spott/NumitronClock/review/NumitronTop-bottom.png

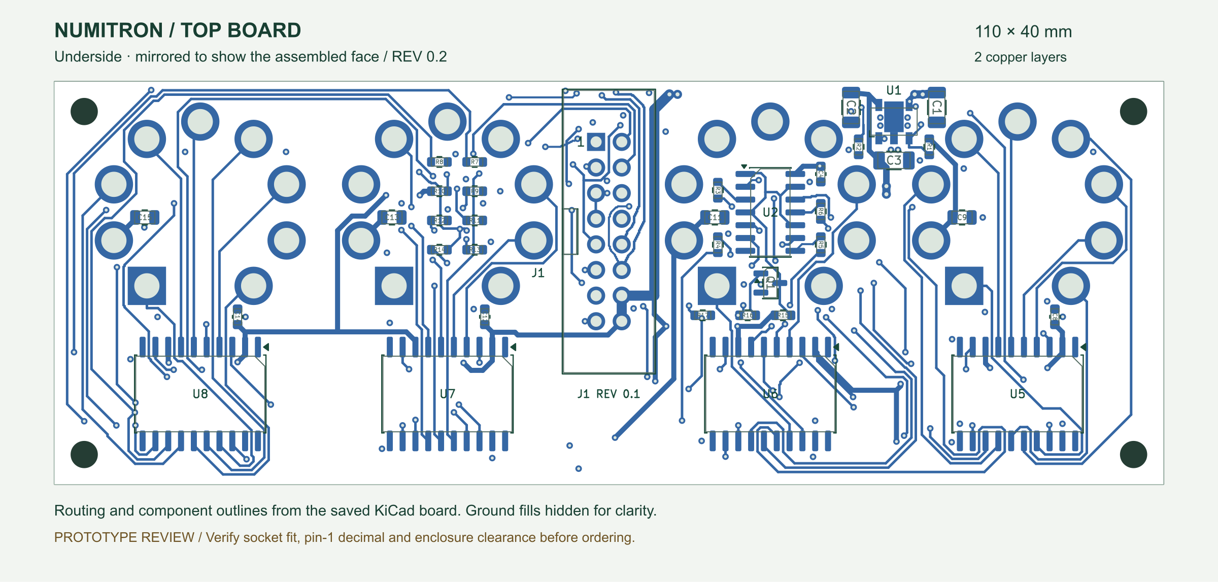
review/NumitronTop-bottom.png
