spott/NumitronClock/review/NumitronTop-top.png

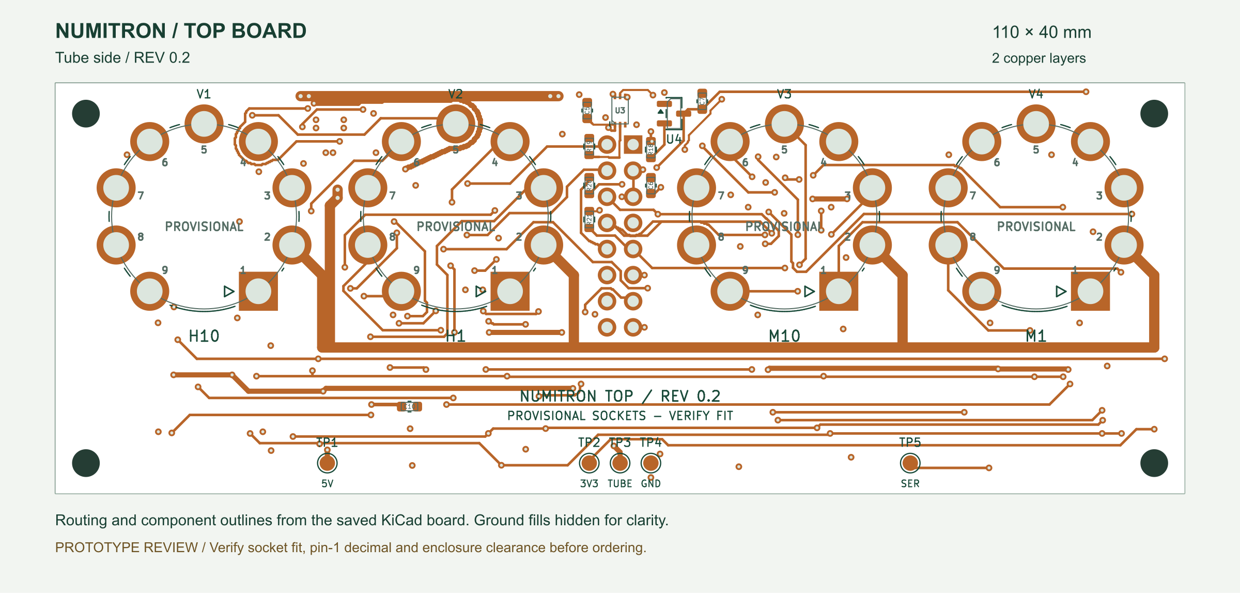
review/NumitronTop-top.png
