spott/NumitronClock/docs/bom.md

# Preliminary top-board BOM

Revision 0.2. Generated from the exported native KiCad netlist by `scripts/update_bom.py`. Quantities are for one top board. This is a review BOM, not an order or an assembly release.

| References | Qty | Value / function | Manufacturer part number | Footprint | Assembly | Datasheet |
|---|---:|---|---|---|---|---|
| C1, C2, C3 | 3 | 10u 25V X7R | KYOCERA AVX X7R family; exact order code pending | Capacitor_SMD:C_1206_3216Metric | Fit | [PDF](../datasheets/avx-x7r.pdf) |
| C4, C5, C6, C7, C8, C10, C12, C14 | 8 | 100n 50V X7R | KYOCERA AVX X7R family; exact order code pending | Capacitor_SMD:C_0603_1608Metric | Fit | [PDF](../datasheets/avx-x7r.pdf) |
| C9, C11, C13, C15 | 4 | 1u 25V X7R | KYOCERA AVX X7R family; exact order code pending | Capacitor_SMD:C_0805_2012Metric | Fit | [PDF](../datasheets/avx-x7r.pdf) |
| J1 | 1 | 61201621621 | 61201621621 | Numitron:Wurth_61201621621_2x08_P2.54mm | Fit | [PDF](../datasheets/idc-header.pdf) |
| Q1 | 1 | MMBT3904-7-F | MMBT3904-7-F | Package_TO_SOT_SMD:SOT-23 | Fit | [PDF](../datasheets/mmbt3904.pdf) |
| R1 | 1 | 46.4k 1% | RC0603FR-0746K4L | Resistor_SMD:R_0603_1608Metric | Fit | [PDF](../datasheets/RC0603FR-0746K4L.pdf) |
| R2 | 1 | 10k 1% | RC0603FR-0710KL | Resistor_SMD:R_0603_1608Metric | Fit | [PDF](../datasheets/RC0603FR-0710KL.pdf) |
| R3, R4, R5, R6 | 4 | 33R | RC0603FR-0733RL | Resistor_SMD:R_0603_1608Metric | Fit | [PDF](../datasheets/RC0603FR-0733RL.pdf) |
| R7, R8, R9 | 3 | 100k | RC0603FR-07100KL | Resistor_SMD:R_0603_1608Metric | Fit | [PDF](../datasheets/RC0603FR-07100KL.pdf) |
| R10, R16 | 2 | 2.2k | RC0603FR-072K2L | Resistor_SMD:R_0603_1608Metric | Fit | [PDF](../datasheets/RC0603FR-072K2L.pdf) |
| R11, R12, R13, R14, R17 | 5 | 4.7k | RC0603FR-074K7L | Resistor_SMD:R_0603_1608Metric | Fit | [PDF](../datasheets/RC0603FR-074K7L.pdf) |
| R15, R18 | 2 | 1k | RC0603FR-071KL | Resistor_SMD:R_0603_1608Metric | Fit | [PDF](../datasheets/RC0603FR-071KL.pdf) |
| R19 | 1 | 10k | RC0603FR-0710KL | Resistor_SMD:R_0603_1608Metric | Fit | [PDF](../datasheets/RC0603FR-0710KL.pdf) |
| R20, R21 | 2 | 4.7k | RC0603FR-074K7L | Resistor_SMD:R_0603_1608Metric | DNP | [PDF](../datasheets/RC0603FR-074K7L.pdf) |
| U1 | 1 | AP7361C-Y5-13 | AP7361C-Y5-13 | Numitron:Diodes_SOT89-5_AP7361C | Fit | [PDF](../datasheets/AP7361C.pdf) |
| U2 | 1 | SN74AHCT125DR | SN74AHCT125DR | Package_SO:SOIC-14_3.9x8.7mm_P1.27mm | Fit | [PDF](../datasheets/sn74ahct125.pdf) |
| U3 | 1 | BH1750FVI-TR | BH1750FVI-TR | Numitron:ROHM_WSOF6I_BH1750_NoCenterPad | Fit | [PDF](../datasheets/bh1750fvi.pdf) |
| U4 | 1 | TLV809EA29DBZR | TLV809EA29DBZR | Package_TO_SOT_SMD:SOT-23 | Fit | [PDF](../datasheets/tlv809e.pdf) |
| U5, U6, U7, U8 | 4 | TPIC6B595DWR | TPIC6B595DWR | Package_SO:SOIC-20W_7.5x12.8mm_P1.27mm | Fit | [PDF](../datasheets/tpic6b595.pdf) |
| V1, V2, V3, V4 | 4 | DR2000 / GZC9-A | DR2000 | Numitron:GZC9-A_B9A_Provisional | Tubes in hand; sockets separate below | [PDF](../datasheets/dr2000.pdf) |

## Mechanical and cable items

| Item | Quantity | Selection / status |
|---|---:|---|
| Tube sockets | 4 | Ordered GZC9-A, [Amazon B0BGBJ7L41](https://www.amazon.com/dp/B0BGBJ7L41). [Drawing](../datasheets/GZC9-A_socket-dimensions.jpg) archived; [provisional footprint assumptions](socket.md) authorized 2026-09-25. Assigned to V1-V4 for layout; check physical fit before ordering. |
| Cable female connectors | 2 | Wurth 61201623021, [datasheet](../datasheets/idc-socket.pdf). One at each cable end. |
| Strain-relief caps | 2 | Included in the selected Wurth socket's with-strain-relief specification; confirm supplied pieces and assembled clearance. |
| Ribbon cable | ~150 mm initially | 3M 3365/16, 28 AWG, 1.27 mm pitch, [datasheet](../datasheets/3m-3365-ribbon.pdf). Final length follows the debugging/enclosure clearance check. |
| Board spacers / screws | TBD | Four M2.5 positions with 2.7 mm nonplated holes at (3,3), (107,3), (3,37), (107,37) mm. Target 25-30 mm board separation; confirm actual screw/spacer and cable clearance. |

TP1-TP5 are bare PCB test pads; they require no purchased components. The bottom-board mate of J1 is outside this top-board BOM.

## Assembly notes

- R20/R21 are omitted when the bottom board supplies the I2C pull-ups. All selected resistors are Yageo RC0603, 1%, 0.1 W; individual part specifications are archived.
- Capacitor footprint sizes, voltage ratings and dielectric are specified, but exact order codes remain pending. Select from the archived KYOCERA AVX X7R family, and verify effective capacitance at bias before freezing the BOM. C2+C3 must retain at least 2.2 uF total.
- V1-V4 use Numitron:GZC9-A_B9A_Provisional: assumed 0.5 mm terminal thickness, 18 mm pad circle, 2.5 mm plated holes and 3.8 mm copper pads. The owner authorized using these estimates for layout; verify fit before ordering.
- U3 uses the custom six-land WSOF6I footprint with no soldered centre pad and a front copper keepout; see layout notes for the older package drawing correspondence. U1 and J1 use manufacturer-specific local footprints.
- U1's C507885 identifier comes from the Obsidian plan. Stock, price, assembly-house availability and substitutions have not been qualified.
- Use normal-pinout TLV809EA29DBZR, not an R/V pinout variant. Use AHCT logic, not HC. The four TPIC parts use the wide SOIC-20 package.
