spott/NumitronClock/hardware/top-board/NumitronTop.kicad_pcb

## KiCad design hardware/top-board/NumitronTop.kicad_pcb (2026-09-26)

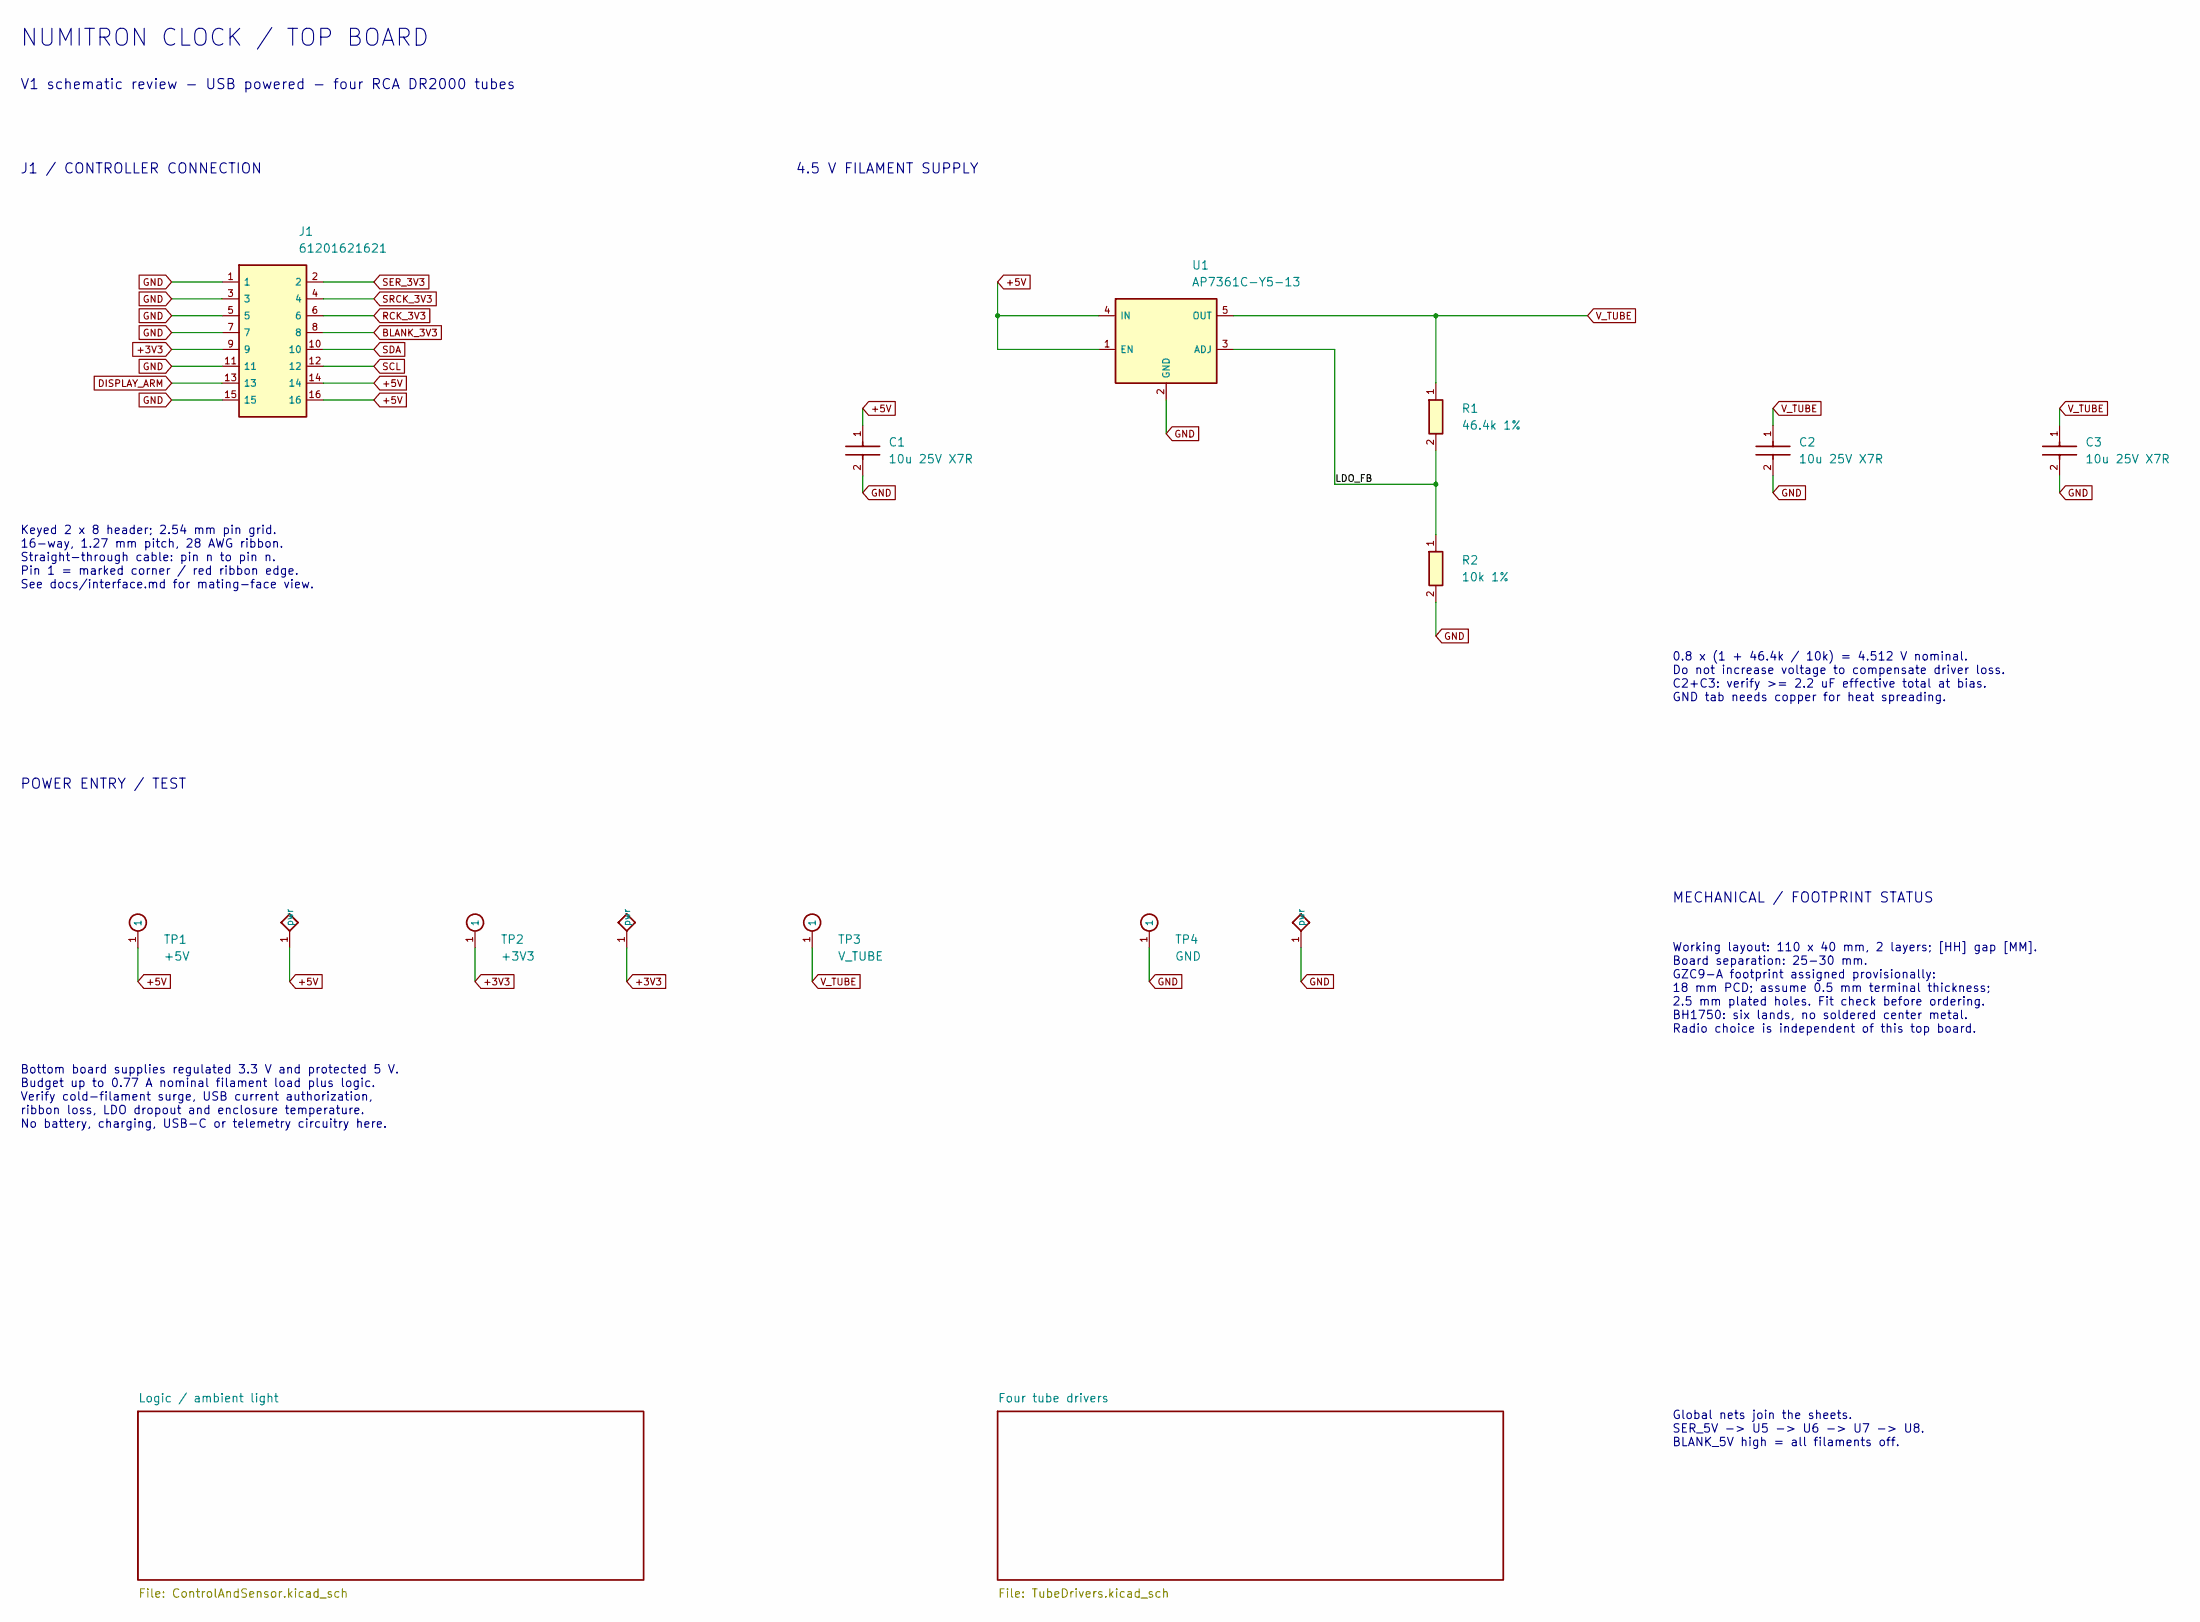
[picture p4: schematic NumitronTop.kicad_sch, Top board: power and interface]

Parts:
C1, C2, C3: 10u 25V X7R; C_1206_3216Metric
J1: 61201621621; Wurth_61201621621_2x08_P2.54mm; MPN 61201621621
R1: 46.4k 1%; R_0603_1608Metric; MPN RC0603FR-0746K4L
R2: 10k 1%; R_0603_1608Metric; MPN RC0603FR-0710KL
TP1: +5V; TestPoint_Pad_D1.5mm
TP2: +3V3; TestPoint_Pad_D1.5mm
TP3: V_TUBE; TestPoint_Pad_D1.5mm
TP4: GND; TestPoint_Pad_D1.5mm
U1: AP7361C-Y5-13; Diodes_SOT89-5_AP7361C; MPN AP7361C-Y5-13; LCSC C507885

Connections:
+3V3: J1.9, TP2.1; also elsewhere on the board
+5V: C1.1, J1.14, J1.16, TP1.1, U1.1 (EN), U1.4 (IN); also elsewhere on the board
/LDO_FB: R1.2, R2.1, U1.3 (ADJ)
BLANK_3V3: J1.8; also elsewhere on the board
DISPLAY_ARM: J1.13; also elsewhere on the board
GND: C1.2, C2.2, C3.2, J1.1, J1.3, J1.5, J1.7, J1.11, J1.15, R2.2, TP4.1, U1.2 (GND); also elsewhere on the board
RCK_3V3: J1.6; also elsewhere on the board
SCL: J1.12; also elsewhere on the board
SDA: J1.10; also elsewhere on the board
SER_3V3: J1.2; also elsewhere on the board
SRCK_3V3: J1.4; also elsewhere on the board
V_TUBE: C2.1, C3.1, R1.1, TP3.1, U1.5 (OUT); also elsewhere on the board

Notes on the sheet:
NUMITRON CLOCK / TOP BOARD
V1 schematic review - USB powered - four RCA DR2000 tubes
J1 / CONTROLLER CONNECTION
Keyed 2 x 8 header; 2.54 mm pin grid. 16-way, 1.27 mm pitch, 28 AWG ribbon. Straight-through cable: pin n to pin n. Pin 1 = marked corner / red ribbon edge. See docs/interface.md for mating-face view.
4.5 V FILAMENT SUPPLY
0.8 x (1 + 46.4k / 10k) = 4.512 V nominal. Do not increase voltage to compensate driver loss. C2+C3: verify >= 2.2 uF effective total at bias. GND tab needs copper for heat spreading.
POWER ENTRY / TEST
Bottom board supplies regulated 3.3 V and protected 5 V. Budget up to 0.77 A nominal filament load plus logic. Verify cold-filament surge, USB current authorization, ribbon loss, LDO dropout and enclosure temperature. No battery, charging, USB-C or telemetry circuitry here.
MECHANICAL / FOOTPRINT STATUS
Working layout: 110 x 40 mm, 2 layers; [HH] gap [MM]. Board separation: 25-30 mm. GZC9-A footprint assigned provisionally: 18 mm PCD; assume 0.5 mm terminal thickness; 2.5 mm plated holes. Fit check before ordering. BH1750: six lands, no soldered center metal. Radio choice is independent of this to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
Global nets join the sheets. SER_5V -> U5 -> U6 -> U7 -> U8. BLANK_5V high = all filaments off.

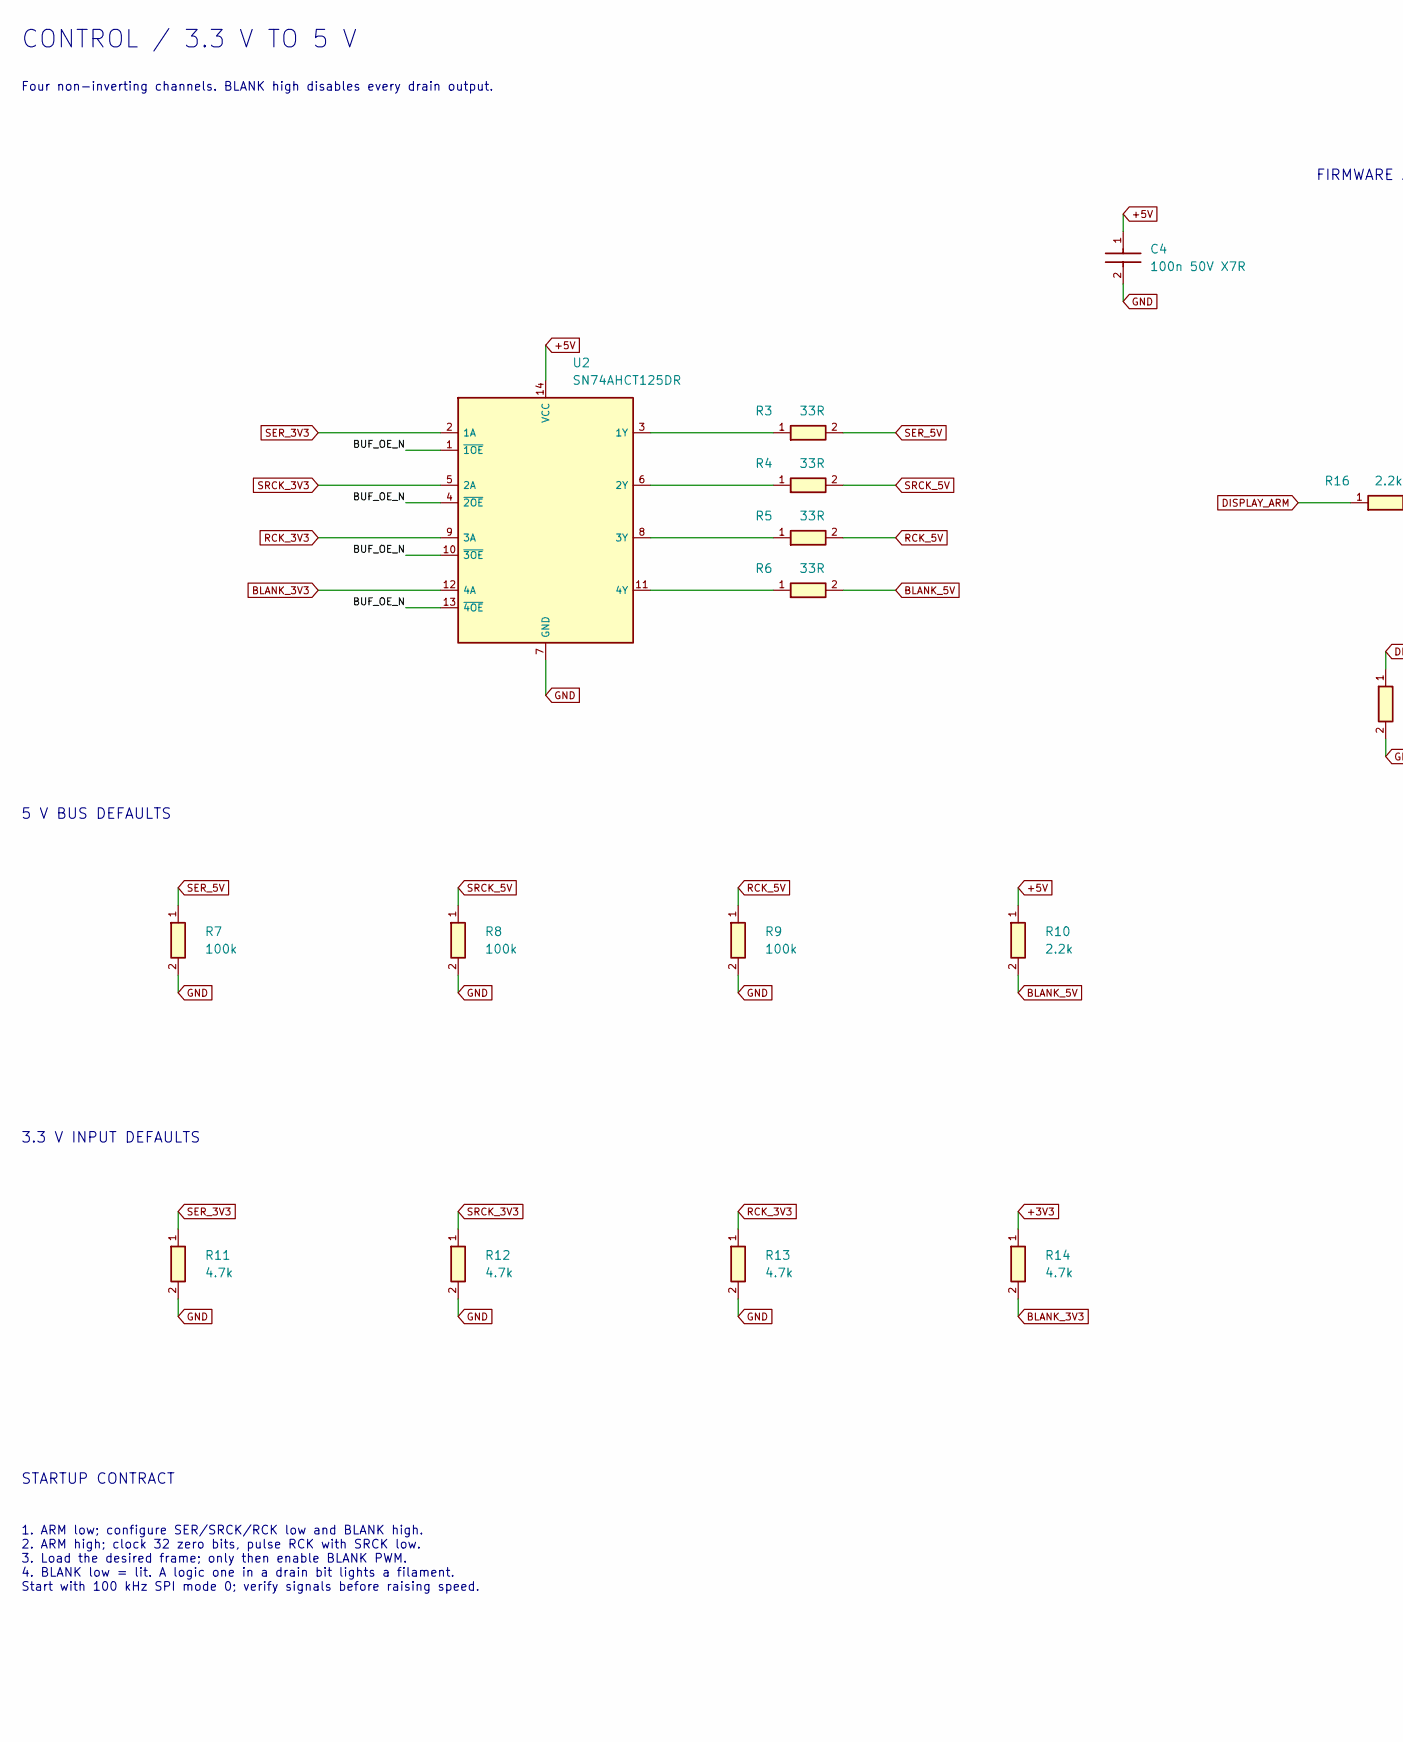
[picture p5: schematic ControlAndSensor.kicad_sch, Top board: control and light sensor, part in row 1, column 1]

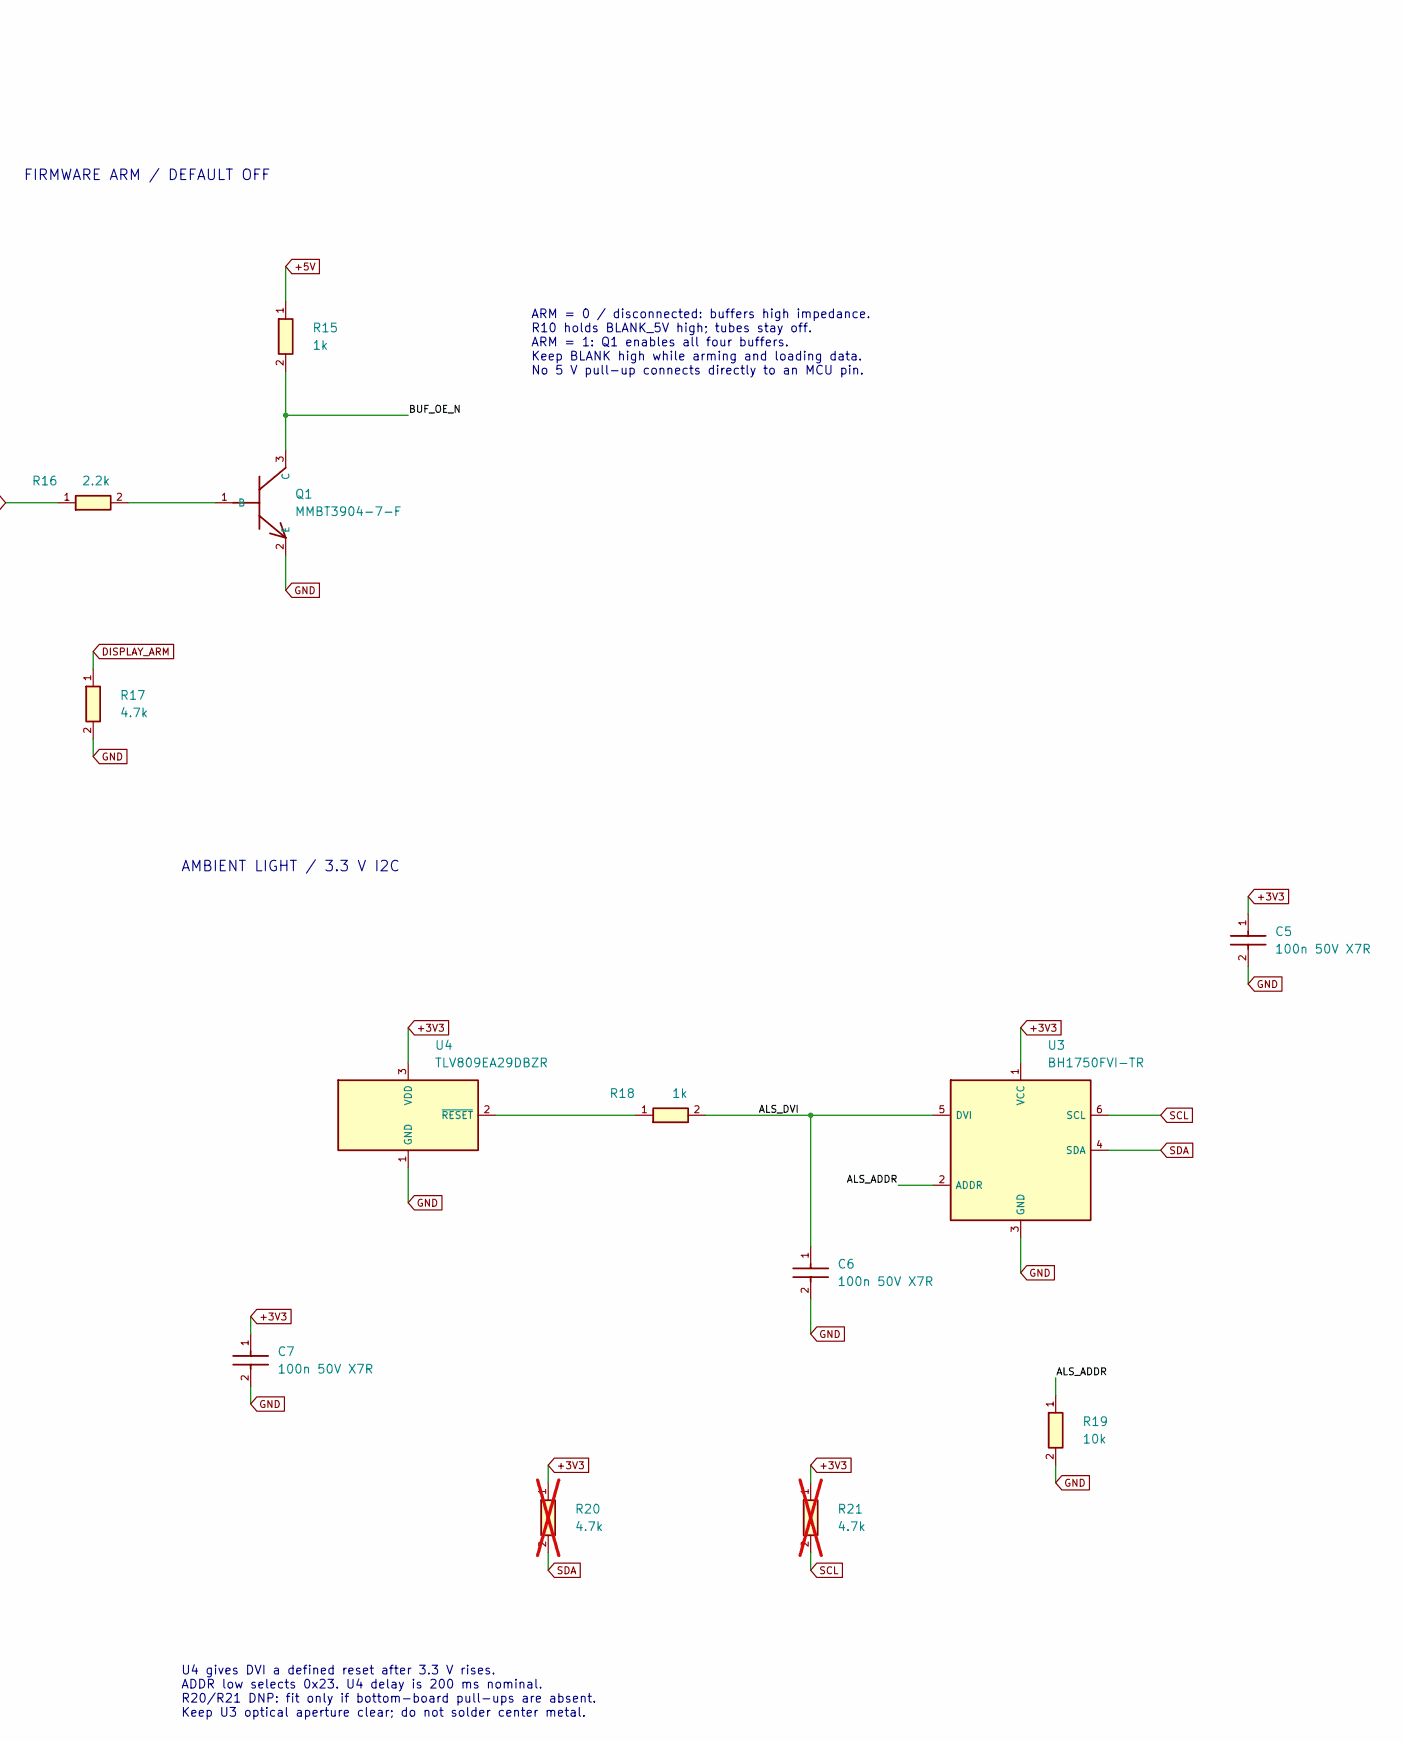
[picture p6: schematic ControlAndSensor.kicad_sch, Top board: control and light sensor, part in row 1, column 2]

Parts:
C4, C5, C6, C7: 100n 50V X7R; C_0603_1608Metric
Q1: MMBT3904-7-F; SOT-23; MPN MMBT3904-7-F
R3, R4, R5, R6: 33R; R_0603_1608Metric; MPN RC0603FR-0733RL
R7, R8, R9: 100k; R_0603_1608Metric; MPN RC0603FR-07100KL
R10, R16: 2.2k; R_0603_1608Metric; MPN RC0603FR-072K2L
R11, R12, R13, R14, R17: 4.7k; R_0603_1608Metric; MPN RC0603FR-074K7L
R15, R18: 1k; R_0603_1608Metric; MPN RC0603FR-071KL
R19: 10k; R_0603_1608Metric; MPN RC0603FR-0710KL
R20, R21: 4.7k; R_0603_1608Metric; MPN RC0603FR-074K7L; not fitted
U2: SN74AHCT125DR; SOIC-14_3.9x8.7mm_P1.27mm; MPN SN74AHCT125DR
U3: BH1750FVI-TR; ROHM_WSOF6I_BH1750_NoCenterPad; MPN BH1750FVI-TR
U4: TLV809EA29DBZR; SOT-23; MPN TLV809EA29DBZR

Connections:
+3V3: C5.1, C7.1, R14.1, R20.1, R21.1, U3.1 (VCC), U4.3 (VDD); also elsewhere on the board
+5V: C4.1, R10.1, R15.1, U2.14 (VCC); also elsewhere on the board
/Logic / ambient light/ALS_ADDR: R19.1, U3.2 (ADDR)
/Logic / ambient light/ALS_DVI: C6.1, R18.2, U3.5 (DVI)
/Logic / ambient light/BUF_OE_N: Q1.3 (C), R15.2, U2.1 (~1OE), U2.4 (~2OE), U2.10 (~3OE), U2.13 (~4OE)
BLANK_3V3: R14.2, U2.12 (4A); also elsewhere on the board
BLANK_5V: R6.2, R10.2; also elsewhere on the board
DISPLAY_ARM: R16.1, R17.1; also elsewhere on the board
GND: C4.2, C5.2, C6.2, C7.2, Q1.2 (E), R7.2, R8.2, R9.2, R11.2, R12.2, R13.2, R17.2, R19.2, U2.7 (GND), U3.3 (GND), U4.1 (GND); also elsewhere on the board
unnamed: Q1.1 (B), R16.2
unnamed: R3.1, U2.3 (1Y)
unnamed: R4.1, U2.6 (2Y)
unnamed: R5.1, U2.8 (3Y)
unnamed: R6.1, U2.11 (4Y)
unnamed: R18.1, U4.2 (~RESET)
RCK_3V3: R13.1, U2.9 (3A); also elsewhere on the board
RCK_5V: R5.2, R9.1; also elsewhere on the board
SCL: R21.2, U3.6 (SCL); also elsewhere on the board
SDA: R20.2, U3.4 (SDA); also elsewhere on the board
SER_3V3: R11.1, U2.2 (1A); also elsewhere on the board
SER_5V: R3.2, R7.1; also elsewhere on the board
SRCK_3V3: R12.1, U2.5 (2A); also elsewhere on the board
SRCK_5V: R4.2, R8.1; also elsewhere on the board

Notes on the sheet:
CONTROL / 3.3 V TO 5 V
Four non-inverting channels. BLANK high disables every drain output.
FIRMWARE ARM / DEFAULT OFF
ARM = 0 / disconnected: buffers high impedance. R10 holds BLANK_5V high; tubes stay off. ARM = 1: Q1 enables all four buffers. Keep BLANK high while arming and loading data. No 5 V pull-up connects directly to an MCU pin.
5 V BUS DEFAULTS
3.3 V INPUT DEFAULTS
STARTUP CONTRACT
1. ARM low; configure SER/SRCK/RCK low and BLANK high. 2. ARM high; clock 32 zero bits, pulse RCK with SRCK low. 3. Load the desired frame; only then enable BLANK PWM. 4. BLANK low = lit. A logic one in a drain bit lights a filament. Start with 100 kHz SPI mode 0; verify signals before raising spee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
AMBIENT LIGHT / 3.3 V I2C
U4 gives DVI a defined reset after 3.3 V rises. ADDR low selects 0x23. U4 delay is 200 ms nominal. R20/R21 DNP: fit only if bottom-board pull-ups are absent. Keep U3 optical aperture clear; do not solder center metal.

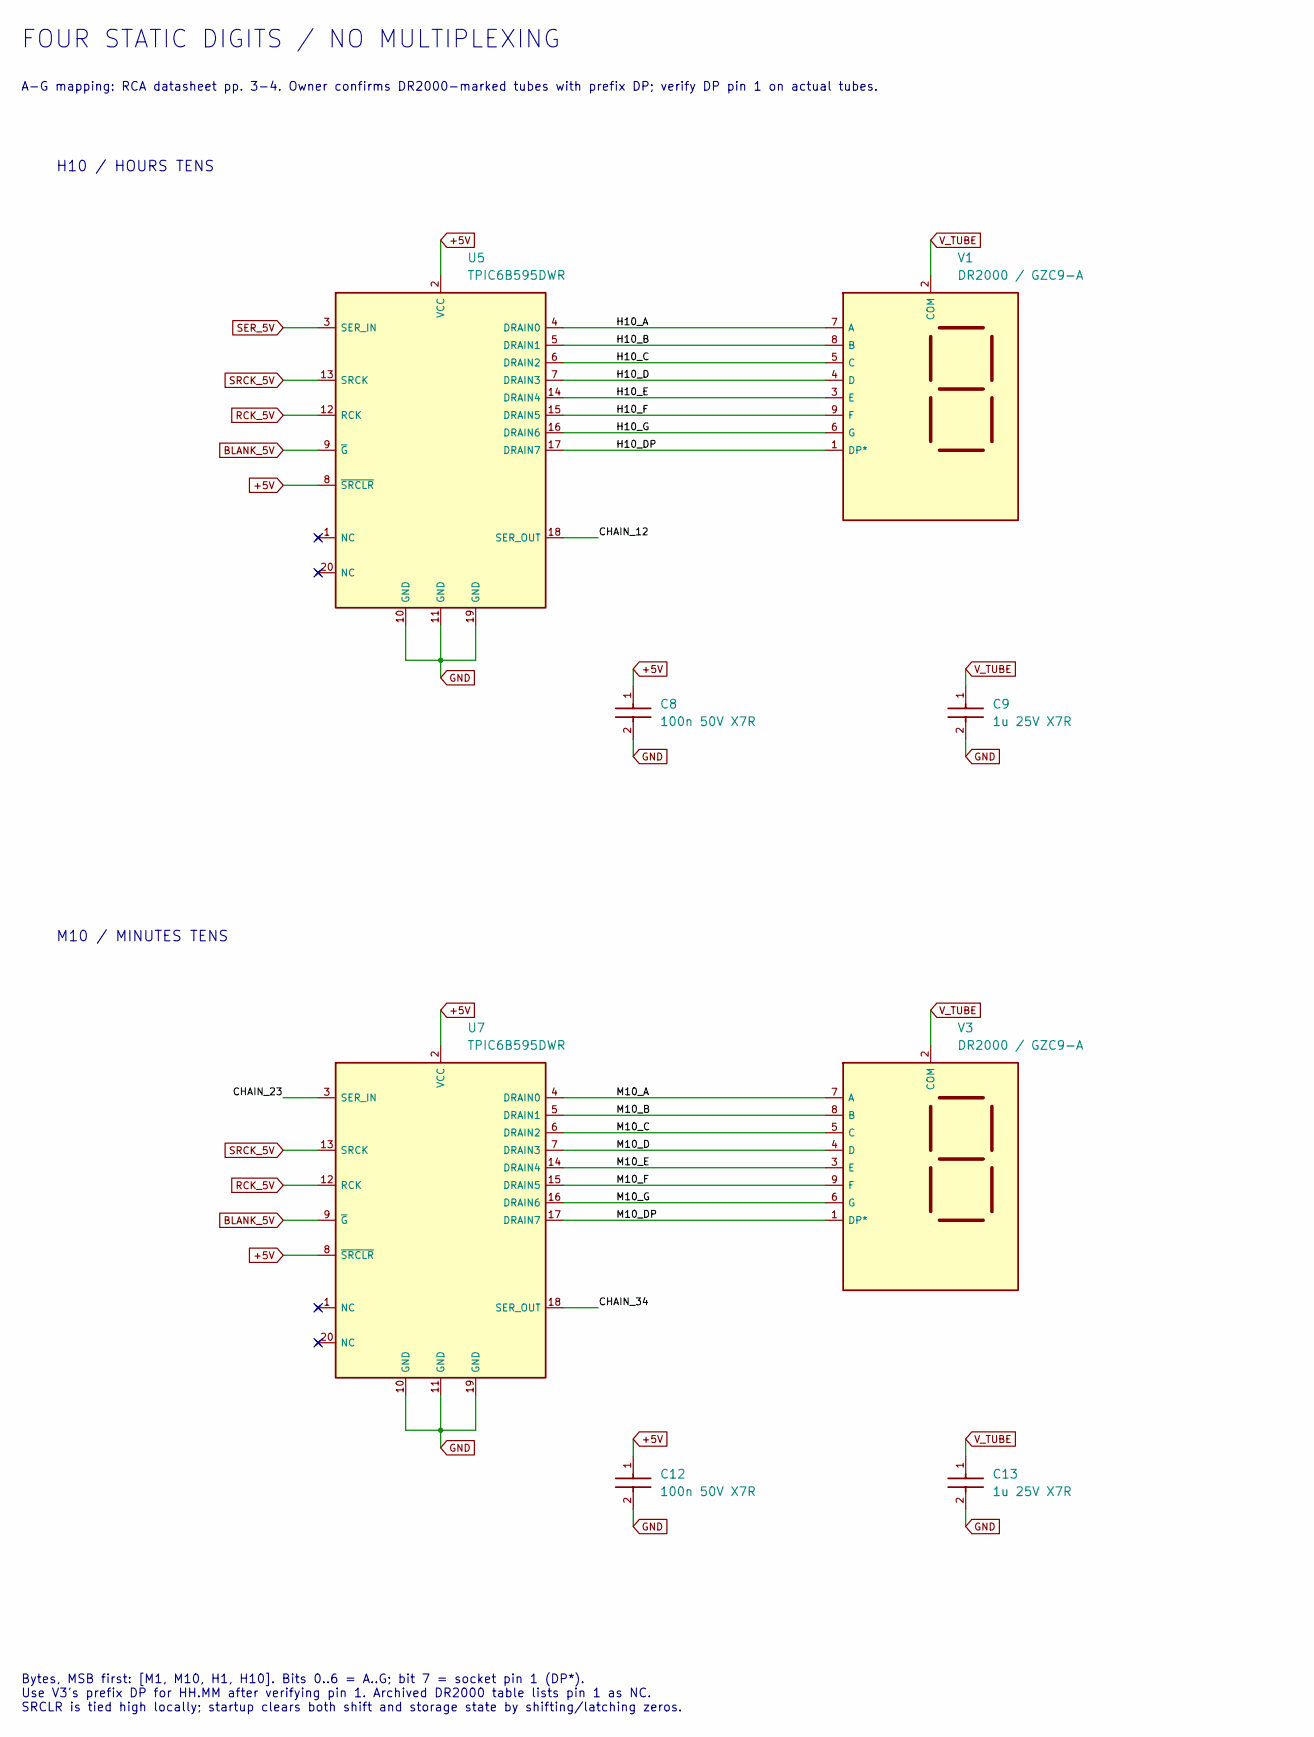
[picture p7: schematic TubeDrivers.kicad_sch, Top board: tube drivers, part in row 1, column 1]

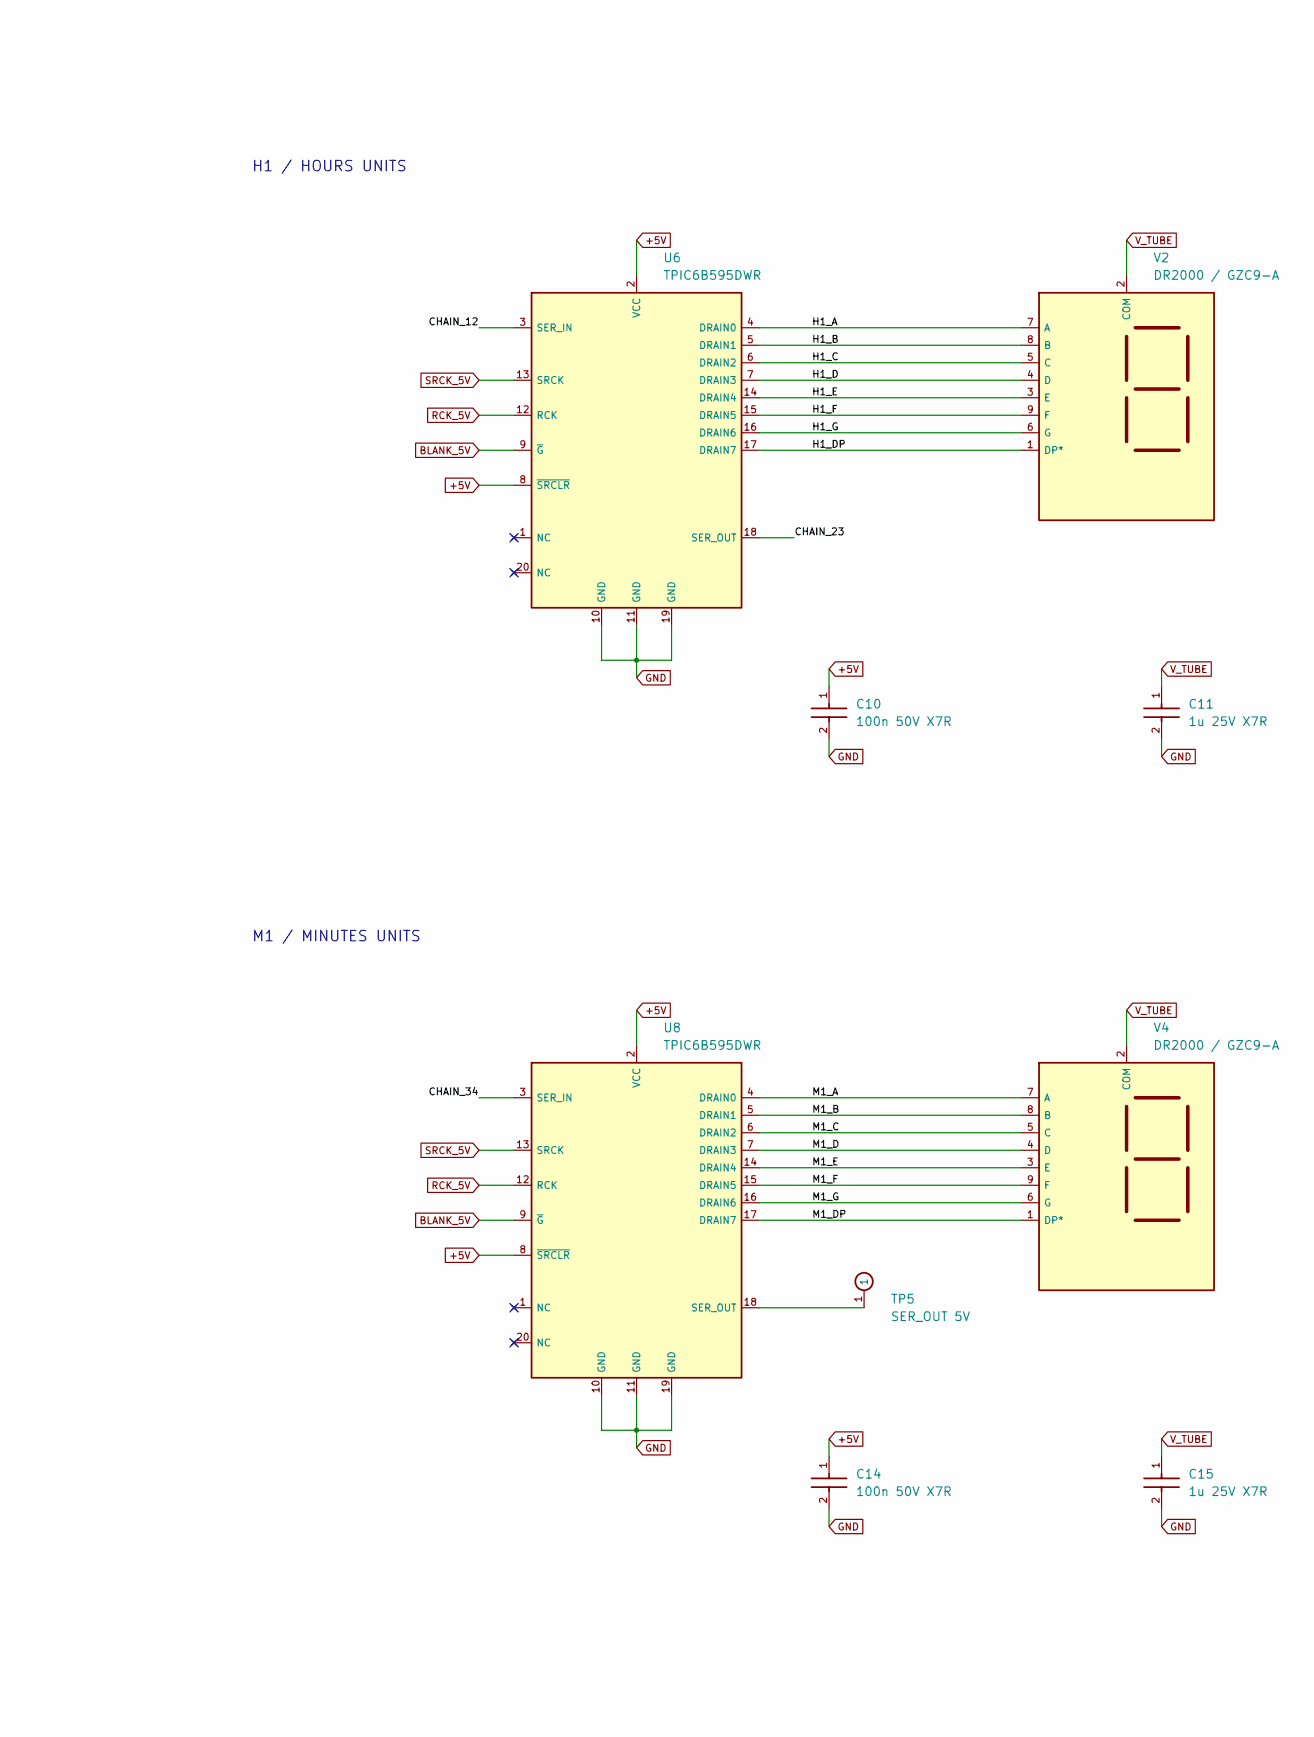
[picture p8: schematic TubeDrivers.kicad_sch, Top board: tube drivers, part in row 1, column 2]

Parts:
C8, C10, C12, C14: 100n 50V X7R; C_0603_1608Metric
C9, C11, C13, C15: 1u 25V X7R; C_0805_2012Metric
TP5: SER_OUT 5V; TestPoint_Pad_D1.5mm
U5, U6, U7, U8: TPIC6B595DWR; SOIC-20W_7.5x12.8mm_P1.27mm; MPN TPIC6B595DWR
V1, V2, V3, V4: DR2000 / GZC9-A; GZC9-A_B9A_Provisional; MPN DR2000

Connections:
+5V: C8.1, C10.1, C12.1, C14.1, U5.2 (VCC), U5.8 (~SRCLR), U6.2 (VCC), U6.8 (~SRCLR), U7.2 (VCC), U7.8 (~SRCLR), U8.2 (VCC), U8.8 (~SRCLR); also elsewhere on the board
/Four tube drivers/CHAIN_12: U5.18 (SER_OUT), U6.3 (SER_IN)
/Four tube drivers/CHAIN_23: U6.18 (SER_OUT), U7.3 (SER_IN)
/Four tube drivers/CHAIN_34: U7.18 (SER_OUT), U8.3 (SER_IN)
/Four tube drivers/H1_A: U6.4 (DRAIN0), V2.7 (A)
/Four tube drivers/H1_B: U6.5 (DRAIN1), V2.8 (B)
/Four tube drivers/H1_C: U6.6 (DRAIN2), V2.5 (C)
/Four tube drivers/H1_D: U6.7 (DRAIN3), V2.4 (D)
/Four tube drivers/H1_DP: U6.17 (DRAIN7), V2.1 (DP*)
/Four tube drivers/H1_E: U6.14 (DRAIN4), V2.3 (E)
/Four tube drivers/H1_F: U6.15 (DRAIN5), V2.9 (F)
/Four tube drivers/H1_G: U6.16 (DRAIN6), V2.6 (G)
/Four tube drivers/H10_A: U5.4 (DRAIN0), V1.7 (A)
/Four tube drivers/H10_B: U5.5 (DRAIN1), V1.8 (B)
/Four tube drivers/H10_C: U5.6 (DRAIN2), V1.5 (C)
/Four tube drivers/H10_D: U5.7 (DRAIN3), V1.4 (D)
/Four tube drivers/H10_DP: U5.17 (DRAIN7), V1.1 (DP*)
/Four tube drivers/H10_E: U5.14 (DRAIN4), V1.3 (E)
/Four tube drivers/H10_F: U5.15 (DRAIN5), V1.9 (F)
/Four tube drivers/H10_G: U5.16 (DRAIN6), V1.6 (G)
/Four tube drivers/M1_A: U8.4 (DRAIN0), V4.7 (A)
/Four tube drivers/M1_B: U8.5 (DRAIN1), V4.8 (B)
/Four tube drivers/M1_C: U8.6 (DRAIN2), V4.5 (C)
/Four tube drivers/M1_D: U8.7 (DRAIN3), V4.4 (D)
/Four tube drivers/M1_DP: U8.17 (DRAIN7), V4.1 (DP*)
/Four tube drivers/M1_E: U8.14 (DRAIN4), V4.3 (E)
/Four tube drivers/M1_F: U8.15 (DRAIN5), V4.9 (F)
/Four tube drivers/M1_G: U8.16 (DRAIN6), V4.6 (G)
/Four tube drivers/M10_A: U7.4 (DRAIN0), V3.7 (A)
/Four tube drivers/M10_B: U7.5 (DRAIN1), V3.8 (B)
/Four tube drivers/M10_C: U7.6 (DRAIN2), V3.5 (C)
/Four tube drivers/M10_D: U7.7 (DRAIN3), V3.4 (D)
/Four tube drivers/M10_DP: U7.17 (DRAIN7), V3.1 (DP*)
/Four tube drivers/M10_E: U7.14 (DRAIN4), V3.3 (E)
/Four tube drivers/M10_F: U7.15 (DRAIN5), V3.9 (F)
/Four tube drivers/M10_G: U7.16 (DRAIN6), V3.6 (G)
BLANK_5V: U5.9 (~G), U6.9 (~G), U7.9 (~G), U8.9 (~G); also elsewhere on the board
GND: C8.2, C9.2, C10.2, C11.2, C12.2, C13.2, C14.2, C15.2, U5.10 (GND), U5.11 (GND), U5.19 (GND), U6.10 (GND), U6.11 (GND), U6.19 (GND), U7.10 (GND), U7.11 (GND), U7.19 (GND), U8.10 (GND), U8.11 (GND), U8.19 (GND); also elsewhere on the board
unnamed: TP5.1, U8.18 (SER_OUT)
RCK_5V: U5.12 (RCK), U6.12 (RCK), U7.12 (RCK), U8.12 (RCK); also elsewhere on the board
SER_5V: U5.3 (SER_IN); also elsewhere on the board
SRCK_5V: U5.13 (SRCK), U6.13 (SRCK), U7.13 (SRCK), U8.13 (SRCK); also elsewhere on the board
V_TUBE: C9.1, C11.1, C13.1, C15.1, V1.2 (COM), V2.2 (COM), V3.2 (COM), V4.2 (COM); also elsewhere on the board

Notes on the sheet:
FOUR STATIC DIGITS / NO MULTIPLEXING
A-G mapping: RCA datasheet pp. 3-4. Owner confirms DR2000-marked tubes with prefix DP; verify DP pin 1 on actual tubes.
H10 / HOURS TENS
H1 / HOURS UNITS
M10 / MINUTES TENS
M1 / MINUTES UNITS
Bytes, MSB first: [M1, M10, H1, H10]. Bits 0..6 = A..G; bit 7 = socket pin 1 (DP*). Use V3's prefix DP for HH.MM after verifying pin 1. Archived DR2000 table lists pin 1 as NC. SRCLR is tied high locally; startup clears both shift and storage state by shifting/latching zeros.

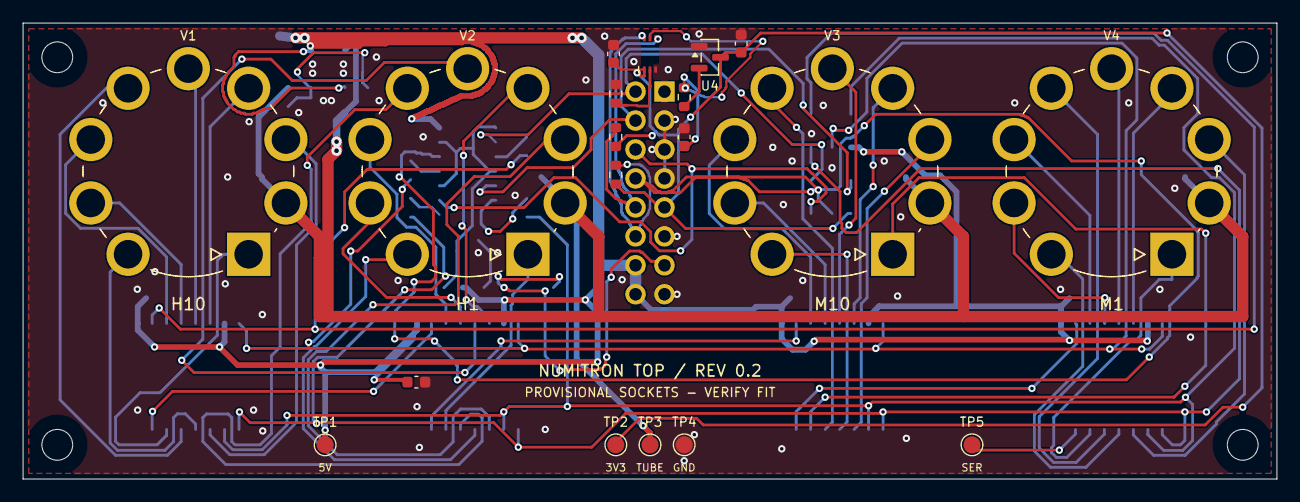
[picture p9: board NumitronTop.kicad_pcb from above]

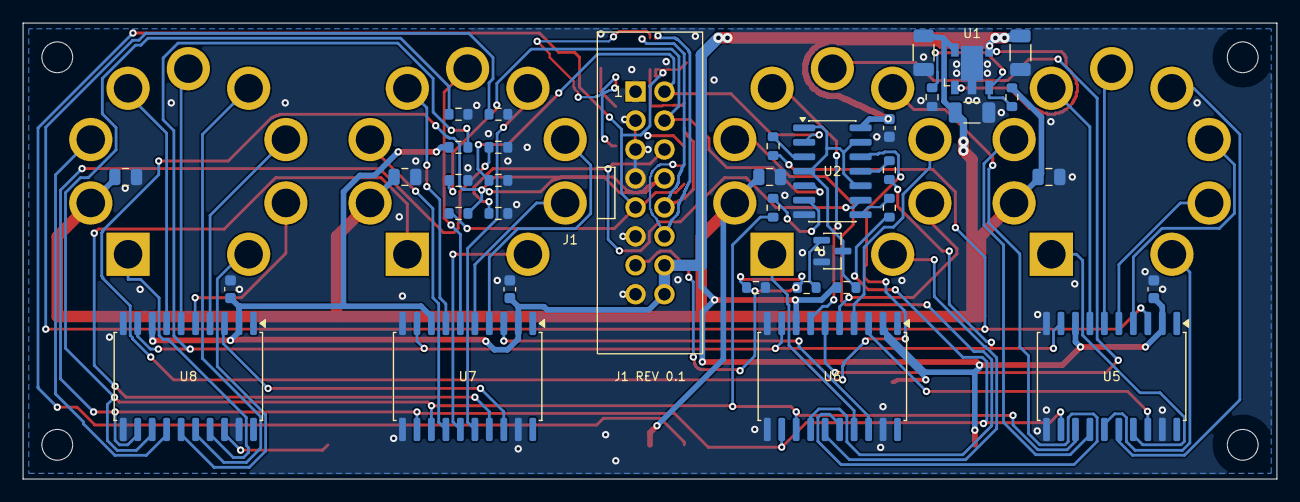
[picture p10: board NumitronTop.kicad_pcb from below]

Board: 2 copper layers, 110.0 x 40.0 mm, 59 parts (36 on the bottom side), 61 nets.

Other parts of the board:
H1, H2, H3, H4: M2.5 / NPTH 2.7; MountingHole_2.7mm_M2.5_BothSides
