spott/NumitronClock/(commit log)

2026-09-19 Capture Numitron top-board schematic and archive component datasheets
    [ControlAndSensor.kicad_sch, NumitronTop.kicad_sch, TubeDrivers.kicad_sch]
2026-09-22 Archive GZC9-A socket drawing and document footprint dimensions
2026-09-26 Add provisional GZC9-A footprint and unblock top-board placement
    [NumitronTop.kicad_sch, TubeDrivers.kicad_sch]
2026-09-26 Add socket-placement preview and native PCB study
    [NumitronTop.kicad_pcb]
2026-09-26 Complete routed top-board prototype layout
    [ControlAndSensor.kicad_sch, NumitronTop.kicad_pcb, NumitronTop.kicad_sch]
2026-10-23 Add ES100 driver and Pico 2 reception test firmware
2026-10-23 ES100 test: separate register reads, IRQ read delay, retry after errors
    - Driver: every register read is an address write followed by a separate
    read transaction. A 2018 time-nuts report says the ES100 rejects combined
    repeated-start reads. The test mock now panics on a combined read.
    - Driver: a "scheduled" next-DST value that fails validation is reported as
    NextDst::Unrecognized with raw values instead of rejecting the frame; the
    datasheet contradicts itself on that hour field.
    - Test program: wait 10 ms after the IRQ edge timestamp before reading IRQ
    Status (the same report says reads at the edge return stale zeros); reread
    while it is 0 and IRQ is still low, up to 10 reads, l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
    [lib.rs, main.rs, tests.rs]
2026-10-23 ES100 test: use the RP2350 internal pull-up on IRQ
    IRQ floats while EN is low. The internal pull-up (about 50 kOhm) holds it
    inactive-high, so no external resistor is required.
    Claude-Session: https://claude.ai/code/session_01JukPZe9rL6LDek3GLxNfqF
